cracked-machine/KicadLibrary/footprint/README.md

tree
.
├── BATTERY
│   └── Panasonic_ML_series.pretty
│       └── ML1220_F1BN.kicad_mod
├── BGA
│   └── STM32MP151_LFBGA.pretty
│       ├── BGA-354_19x19_16.0x16.0mm.kicad_mod
│       └── BGA-448_22x22_18.0x18.0mm.kicad_mod
├── CONNECTORS
│   ├── AUDIO
│   │   ├── Jack_TRRS_3.pretty
│   │   │   └── Jack_TRRS_3.5MM_SJ5-43502PM.kicad_mod
│   │   ├── NeutrikNMJ.pretty
│   │   │   ├── NMJ4HFD2.kicad_mod
│   │   │   └── NMJ6HFD4.kicad_mod
│   │   ├── NeutrikNRJ.pretty
│   │   │   ├── NRJxHx.kicad_mod
│   │   │   └── NRJxHx_NOTAB.kicad_mod
│   │   └── ThonkiConn_3.pretty
│   │       ├── Conn_3.5mmJackMono_Horizontal_PJ302M.kicad_mod
│   │       ├── Conn_3.5mmJackMono_Vertical_PJ301BM.kicad_mod
│   │       ├── Conn_3.5mmJackMono_Vertical_PJ301M-12.kicad_mod
│   │       └── Conn_3.5mmJackStereo_Vertical_PJ301CM.kicad_mod
│   ├── COAX
│   │   └── RSProStraight50OhmPCBMountBulkheadFittingBNC_5260279
│   │       └── RSProStraight50OhmPCBMountBulkheadFittingBNC_5260279.pretty
│   │           └── RSProStraight50OhmPCBMountBulkheadFittingBNC_5260279.kicad_mod
│   ├── MIDI
│   │   └── RS_5P180_DIN5_SOCKET_WSHIELD.pretty
│   │       └── RS_5P180_DIN5_SOCKET_WSHIELD.kicad_mod
│   ├── POWER
│   │   └── MOLEX
│   │       └── MINI_FIT_JNR
│   │           └── Connector_Molex_MiniFitJnrExtra.pretty
│   │               └── Molex_Mini-Fit_Jr_5569-06A2_2x03_P4.20mm_Horizontal.kicad_mod
│   ├── SIGNAL
│   │   ├── IDC_PCB_Edge_Connectors.pretty
│   │   │   └── 2x10_IDC_EdgeConnector.kicad_mod
│   │   ├── Molex_SDIO
│   │   │   └── Molex_SDIO.pretty
│   │   │       └── Molex_SDIO_475710001.kicad_mod
│   │   └── TermiMate One-Circuit Terminal-Style Connector System.pretty
│   │       ├── MOLEX_5050710101
│   │       │   ├── 5050710101.stp
│   │       │   └── readme-and-terms-of-use-3d-cad-models.txt
│   │       ├── MOLEX_5050720101
│   │       │   ├── 5050720101.stp
│   │       │   └── readme-and-terms-of-use-3d-cad-models.txt
│   │       ├── TermiMate_505071_1_Way_1_Row_Right_Angle_PCB_Header.kicad_mod
│   │       └── TermiMate_505072_1_Way_1_Row_Right_Angle_PCB_Socket_SMD.kicad_mod
│   └── USB
│       ├── MolexUSB_TypeC.pretty
│       │   ├── 204711-0001_SMT_Socket_3_1C_Straight_SinglePort.kicad_mod
│       │   └── 213716-0001_THT_Socket_RightAngle.kicad_mod
│       └── USB_Plug_ConnectorLess.pretty
│           └── USB_A_Plug_ConnectorLess.kicad_mod
├── DISPLAYS
│   └── ILI9341_TFTLCD.pretty
│       ├── ILI9341_ResitiveTouch_TFTLCD_2.8inch_85mm_50mm_FrontMount.kicad_mod
│       └── ILI9341_ResitiveTouch_TFTLCD_2.8inch_85mm_50mm_RearMount.kicad_mod
├── ENCLOSURES
│   └── HAMMOND
│       └── Hammond1590.pretty
│           ├── 1590B.kicad_mod
│           ├── 1590BB.kicad_mod
│           └── 1590G.kicad_mod
├── MISC
│   ├── Adafruit Trellis 4x4 3mm HT16K33.pretty
│   │   ├── 1X5_SMT.kicad_mod
│   │   ├── ADAFRUIT_TEXT_20MM.kicad_mod
│   │   ├── ELAST_PAD_SQUARE_10MM_5.4MM_4X4GRID.kicad_mod
│   │   ├── FIDUCIAL_1MM.kicad_mod
│   │   ├── LED3MM-4X4GRID.kicad_mod
│   │   ├── MOUNTINGHOLE_2.5_PLATED.kicad_mod
│   │   ├── R0805.kicad_mod
│   │   ├── SOD-323.kicad_mod
│   │   ├── SOD-323F.kicad_mod
│   │   ├── SOLDERJUMPER_REFLOW_NOPASTE.kicad_mod
│   │   ├── SOP28_300MIL.kicad_mod
│   │   ├── TESTPOINT_SMT.kicad_mod
│   │   └── _0805.kicad_mod
│   ├── KEYPADS
│   │   └── KEYPADS.pretty
│   │       ├── ELAST_PAD_SQUARE_10MM_5.4MM_2X4GRID.kicad_mod
│   │       └── LED3MM-4X4GRID.kicad_mod
│   └── TinyNetTies.pretty
│       ├── NetTie-2_SMD_Pad0.127mm.kicad_mod
│       ├── NetTie-2_SMD_Pad0.254mm.kicad_mod
│       ├── NetTie-3_SMD_Pad0.127mm.kicad_mod
│       └── NetTie-3_SMD_Pad0.254mm.kicad_mod
├── MODULES
│   ├── DISPLAYS
│   │   ├── 0.96inch_OLED_SSD1306.pretty
│   │   │   └── 0.96inch_OLED_SSD1306.kicad_mod
│   │   └── 2.42Inch_OLED_SSD1309.pretty
│   │       └── 2.42Inch_OLED_SSD1309.kicad_mod
│   └── NUCLEO
│       └── ST_Nucleo.pretty
│           ├── ST_Morpho_Connector_144_STLink.kicad_mod
│           └── ST_Morpho_Connector_64_STLink.kicad_mod
├── POTS
│   └── SLIDERS
│       ├── Alpha_Sliders.pretty
│       │   └── RA2045F_Slider_35mm.kicad_mod
│       ├── Bourn_PTA_Slider.pretty
│       │   ├── Slider_PTA1543_30MM.kicad_mod
│       │   ├── Slider_PTA2043_35MM.kicad_mod
│       │   ├── Slider_PTA3043_45MM.kicad_mod
│       │   ├── Slider_PTA4543_60MM.kicad_mod
│       │   └── Slider_PTA6043_75MM.kicad_mod
│       └── Bourn_PTL_Slider.pretty
│           ├── Slider_PTL01_LED_128MM.kicad_mod
│           ├── Slider_PTL20_LED_35MM.kicad_mod
│           ├── Slider_PTL30_LED_45MM.kicad_mod
│           ├── Slider_PTL45_LED_60MM.kicad_mod
│           └── Slider_PTL60_LED_75MM.kicad_mod
├── PWR
│   ├── DC-DC
│   │   └── ISOLATED
│   │       ├── RecomR2D.pretty
│   │       │   └── R2D.kicad_mod
│   │       ├── RecomRS6.pretty
│   │       │   └── RS6.kicad_mod
│   │       ├── TRN_SIP6.pretty
│   │       │   └── TRN_SIP6.kicad_mod
│   │       ├── XP_ISA.pretty
│   │       │   └── ISA0505.kicad_mod
│   │       └── XP_JTF.pretty
│   │           └── JTF0824D12.kicad_mod
│   ├── PMIC
│   │   └── STPMIC1.pretty
│   │       └── WQFN-44L_EP_5x6_Pitch0.4mm.kicad_mod
│   └── REG
│       └── VREF
├── QFN
│   ├── QFN-32-1EP_5x5mm_TestPoints.pretty
│   │   └── QFN-32-1EP_5x5mm_P0.5mm_EP3.3x3.3mm_TestPoints.kicad_mod
│   └── ThinMiniQFN.pretty
│       └── ThinMiniQFN-16_2.6mm_1.8mm.kicad_mod
├── README.md
├── RF
│   └── PCB_Antenna
│       └── PCB_Antenna.pretty
│           ├── Nordic_2_4GHz_Meander_LeftSided.kicad_mod
│           └── Nordic_2_4GHz_Meander_RightSided.kicad_mod
└── SWITCHES
    ├── DailywellSwitches.pretty
    │   ├── Dailywell_DPDT.kicad_mod
    │   └── Dailywell_SPDT.kicad_mod
    ├── JS_Series_Sub-Miniature_Slide_Switches
    │   └── JS_Series_Sub-Miniature_Slide_Switches.pretty
    │       └── JS102011SAQN.kicad_mod
    ├── PCB_SW_LED.pretty
    │   ├── Adafruit_1611_NPTH.kicad_mod
    │   ├── Circular_3mm_10mm_0603.kicad_mod
    │   └── Circular_3mm_10mm_Cree_PLLC6_CLY6D-FKC-CK1N1D1BB7D3D3.kicad_mod
    ├── RS_Switches.pretty
    │   └── SPDT_Slide_Switch_Latching_Vertical_THT_8x9.3mm_734-7303.kicad_mod
    ├── TACTILE
    │   └── 12x12x7_3mmTactilePushButtonMomentary.pretty
    │       └── 12x12x7_3mmTactilePushButtonMomentary.kicad_mod
    └── custom_sw.pretty
        ├── SW_3PDT_W18MM_L17.3MM_P5.3MM_D2MM.kicad_mod
        ├── SW_DPDT_1MD6_W11.43MM_L12.7MM_P4.8MM_D2MM.kicad_mod
        ├── SW_DPDT_W11.43MM_L12.7MM_P4.8MM_D2MM.kicad_mod
        ├── SW_SPDT_W6.86MM_L12.7MM_P4.8MM_D2MM.kicad_mod
        └── SW_SPST_ON_ON_P7_54.kicad_mod

77 directories, 89 files
