cracked-machine/KicadLibrary/symbol/README.md

tree
.
├── AUDIOCONVERTERS
│   ├── CirrusAudioConverters.bck
│   ├── CirrusAudioConverters.dcm
│   └── CirrusAudioConverters.lib
├── CONNECTOR
│   ├── AUDIO
│   │   ├── MonoJack2Switch.bck
│   │   ├── MonoJack2Switch.dcm
│   │   ├── MonoJack2Switch.lib
│   │   ├── audiojack2-connector_numbered.dcm
│   │   └── audiojack2-connector_numbered.lib
│   └── MIDI
│       ├── MidiDin5.kicad_sym
│       └── MidiDin5.lib
├── ENCODER
│   └── RotaryEncoder
│       ├── RotaryEncoder.bck
│       ├── RotaryEncoder.dcm
│       └── RotaryEncoder.lib
├── INTERFACE
│   ├── ADP5587.bck
│   ├── ADP5587.dcm
│   └── ADP5587.lib
├── LOGIC
│   ├── ADG2188.bck
│   ├── ADG2188.dcm
│   ├── ADG2188.lib
│   ├── DG46x.bck
│   ├── DG46x.dcm
│   ├── DG46x.lib
│   ├── DG470.bck
│   ├── DG470.dcm
│   ├── DG470.lib
│   ├── DG61x.bak
│   ├── DG61x.kicad_sym
│   ├── SN74LVC1G3157.bck
│   ├── SN74LVC1G3157.dcm
│   ├── SN74LVC1G3157.lib
│   ├── TS5A3357.bck
│   ├── TS5A3357.dcm
│   └── TS5A3357.lib
├── MCU
│   ├── STM32G031.bck
│   ├── STM32G031.dcm
│   ├── STM32G031.lib
│   ├── STM32G0B1.bck
│   ├── STM32G0B1.dcm
│   ├── STM32G0B1.lib
│   ├── STM32G4.bck
│   ├── STM32G4.dcm
│   └── STM32G4.lib
├── MPU
│   └── STM32MP1
│       ├── STM32MP15x.bck
│       ├── STM32MP15x.dcm
│       └── STM32MP15x.lib
├── OTPO
│   ├── ISOLATORS
│   │   ├── TLP2361.bck
│   │   ├── TLP2361.dcm
│   │   └── TLP2361.lib
│   └── LEDDRIVERS
│       ├── HT16K33.bck
│       ├── HT16K33.dcm
│       ├── HT16K33.lib
│       ├── TLC5955.bck
│       ├── TLC5955.dcm
│       └── TLC5955.lib
├── PGA
│   ├── PGA.bck
│   ├── PGA.dcm
│   └── PGA.lib
├── PWR
│   ├── DC-DC
│   │   ├── CHARGEPUMP
│   │   │   ├── NCP1729.bck
│   │   │   ├── NCP1729.dcm
│   │   │   ├── NCP1729.lib
│   │   │   ├── TPS6040x.bck
│   │   │   ├── TPS6040x.dcm
│   │   │   └── TPS6040x.lib
│   │   └── ISOLATED
│   │       ├── RecomRKZE.bck
│   │       ├── RecomRKZE.dcm
│   │       ├── RecomRKZE.lib
│   │       ├── RecomRS6.bck
│   │       ├── RecomRS6.dcm
│   │       ├── RecomRS6.lib
│   │       ├── TracoTRN1.bck
│   │       ├── TracoTRN1.dcm
│   │       ├── TracoTRN1.lib
│   │       ├── XP_ISA.bck
│   │       ├── XP_ISA.dcm
│   │       ├── XP_ISA.lib
│   │       ├── XP_JTF.bck
│   │       ├── XP_JTF.dcm
│   │       └── XP_JTF.lib
│   ├── LEDDRIVER
│   │   ├── PAM2812.bck
│   │   ├── PAM2812.dcm
│   │   └── PAM2812.lib
│   ├── LOADSW
│   │   ├── SiP3250x.bck
│   │   ├── SiP3250x.dcm
│   │   └── SiP3250x.lib
│   ├── PMIC
│   │   ├── Microchip_PMIC.bck
│   │   ├── Microchip_PMIC.dcm
│   │   ├── Microchip_PMIC.lib
│   │   ├── NXP_PMIC.bck
│   │   ├── NXP_PMIC.dcm
│   │   ├── NXP_PMIC.lib
│   │   ├── ST_PMIC.bck
│   │   ├── ST_PMIC.dcm
│   │   ├── ST_PMIC.lib
│   │   ├── TI_PMIC.bck
│   │   ├── TI_PMIC.dcm
│   │   └── TI_PMIC.lib
│   └── REG
│       ├── LDO
│       │   ├── MIC5233.bck
│       │   ├── MIC5233.dcm
│       │   ├── MIC5233.lib
│       │   ├── MIC5270YM5.bck
│       │   ├── MIC5270YM5.dcm
│       │   ├── MIC5270YM5.lib
│       │   ├── TC59.bck
│       │   ├── TC59.dcm
│       │   └── TC59.lib
│       └── VREF
├── README.md
├── SW
│   ├── PCB_LED_SW.bck
│   ├── PCB_LED_SW.dcm
│   ├── PCB_LED_SW.lib
│   ├── Tactile_SPST-NO.bck
│   ├── Tactile_SPST-NO.dcm
│   └── Tactile_SPST-NO.lib
└── TIMER
    ├── MIC155x.bck
    ├── MIC155x.dcm
    └── MIC155x.lib

27 directories, 115 files
