cracked-machine/KicadLibrary/EdgeTemplates/HammondEnclosures/1590B.dxf

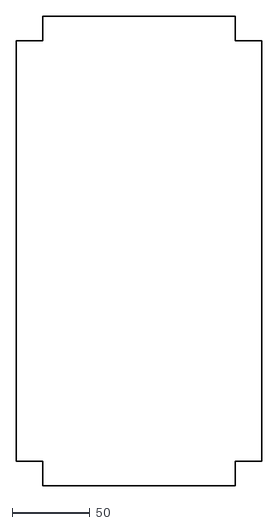
[picture p1: CAD file, 2020-08-15]
EdgeTemplates/HammondEnclosures/1590B.dxf
158.1 x 302.6
