cracked-machine/KicadLibrary/(commit log)

2020-03-02 Added STM32G4 symbol library
2020-03-02 updated stm32G4 symbol library
2020-03-02 updated stm32g4 symbol lib
2020-03-03 added symbol
    NCP1729 charge pump
2020-03-10 added symbol
    TPS60400 charge pump
2020-03-13 Added BNC connector footprint
2020-03-22 added footprints and symbols
2020-03-22 Updated Hammond 1590BB footprint
2020-03-24 Added DG46x switch symbol
2020-03-29 added symbol
    - numbered audio jack socket, mono
2020-03-29 Added LEDDRIVER symbol
    - PAM8212 4 channel linear constant current led driver (SOT23)
2020-03-30 updated bnc coax connector
2020-04-12 updated BNC coax connector footprint
2020-07-16 Added symbols
    MIC155x IttyBitty® RC Timer/Oscillator
2020-07-25 Added ILI9341 2.8" touch screen footprint
2020-08-09 added switch
2020-08-15 Added RSWW SPDT switch - #734-7303
    [1590B.dxf]
2020-08-20 Added Bourns PTA slider footprints
2020-08-23 Added Hammond 1950BB outline "footprint" template
2020-09-06 updated PTA Series fader footprints
2020-09-07 Added footprint/symbol for ISA0505 isolated DC-DC (unreg)
2020-09-19 Added footprints
    - Added 1590B
    - Added 1590G
2020-09-22 Added footprint
    - USB A connectorless (direct PCB)
2020-10-11 Added Cirrus CS4344(DAC) and CS5343(ADC) footprints
2020-10-18 edge connector footprint
2020-11-06 Added STM32MP151
    - STM32MP151AB symbol
    - LFBGA361 and LFBGA484 footprints
2020-11-07 updated STM32MP151/ cloned for STM32MP157
    - Corrected ball-out mistakes
2020-11-07 renamed STM32MP151 to STM32MP15x
2020-11-08 Added Micro-SD connector footprint
    - Molex SDIO 475710001 connector
2020-11-08 updated Molex SDIO 475710001 connector footprint
2020-11-08 updated Molex SDIO 475710001 connector footprint...again
2020-11-09 Added STM32G03§ symbol
    - STM32G031J6xM (SO8N)
2020-11-14 updated STM32MP157 symbol/SDIO 475710001 footprint
2020-11-14 deleted stm32mp151 symbol
2020-11-15 STM32MP15x library change
2020-11-28 updated STM32MP15x.lib
2020-11-28 updated 2x10_IDC_EdgeConnector footprint
2021-01-09 Added PCB Antenna footprint
2021-01-10 corrected STM32MP157 footprint
2021-01-13 updated 2.4GHz meander PCB antenna footprint
2021-02-18 Added JTF0824D12 footprint
2021-02-19 Added STPMIC1 symbol and footprint
2021-02-22 Updated STPMIC footprint
2021-03-10 Added custom "Tiny" NetTie and Lithium ML1220 coincell footprints
2021-03-19 Added Molex THT USB Type C footprint
2021-05-26 Added STM32G0B1 symbols
    STM32G0B1KET6N and STM32G0B1KET
2021-06-09 updated footprint
    made RGB LED pads wider to aid hand soldering
2022-07-16 updated Cree PLLC footprint
2022-07-16 Added ThinMiniQFN footprint
2022-07-16 Added 0.96 OLED footprint with mounting holes
2022-07-16 Corrected DPDT pin numbers
2022-07-16 Added NC pin
2022-09-14 added qfn footprints
2023-03-21 added OLED footprint
2023-03-26 added oled footprint without courtyard/silkscreen
2024-12-20 added SOT-23-THIN-14 footprint
2024-12-20 added dual RCA footprint
2025-01-01 updated pin layout
